meagmohit/vgalib/displayImage/Schematic.BMP

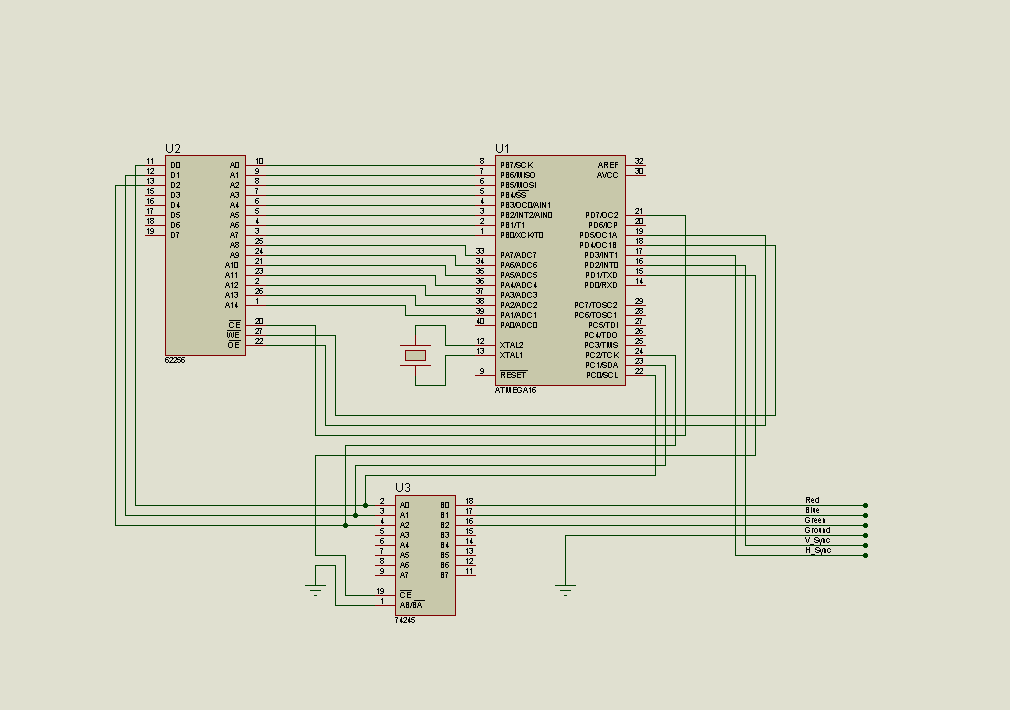
displayImage/Schematic.BMP
