meagmohit/vgalib/(list of files, drawings)

Other design files:
displayImage/Schematic.DSN
pingpong/Game Schematic.DSN
vgalib/Schematic.DSN
