meagmohit/vgalib/displayImage/symbol_tbl.h

prog_char symbol[]={


0b00000111,0b00000111,0b00000111,0b00000111,0b00000111,0b00000111,0b00000111,0b00000111,0b00000111,0b00000111,0b00000111,0b00000111,0b00000111,0b00000111,0b00000111,0b00000111,0b00000111,0b00000111,0b00000111,0b00000111,0b00000111,0b00000111,0b00000111,0b00000111,0b00000111,0b00000111,0b00000111,0b00000111,0b00000111,0b00000111,0b00000111,0b00000111,0b00000111,0b00000111,0b00000111,0b00000111,0b00000111,0b00000111,0b00000111,0b00000111,0b00000111,0b00000111,0b00000111,0b00000111,0b00000111,0b00000111,0b00000111,0b00000111,0b00000111,0b00000111,0b00000111,0b00000111,0b00000111,0b00000111,0b00000111,0b00000111,0b00000111,0b00000111,0b00000111,0b00000111,0b00000111,0b00000111,0b00000111,0b00000111,0b00000111,0b00000111,0b00000111,0b00000111,0b00000111,0b00000111,0b00000111,0b00000111,0b00000111,0b00000111,0b00000111,0b00000111,0b00000111,0b00000111,0b00000111,0b00000111,0b00000111,0b00000111,0b00000111,0b00000111,0b00000111,0b00000111,0b00000111,0b00000111,0b00000111,0b00000111,0b00000111,0b00000111,0b00000111,0b00000111,0b00000111,0b00000111,0b00000111,0b00000111,0b00000111,0b00000111,0b00000111,0b00000111,0b00000111,0b00000111,0b00000111,0b00000111,0b00000111,0b00000111,0b00000111,0b00000111,0b00000111,0b00000111,0b00000111,0b00000111,0b00000111,0b00000111,0b00000111,0b00000111,0b00000111,0b00000111,0b00000111,0b00000111,0b00000111,0b00000111,0b00000111,0b00000111,0b00000111,0b00000111,0b00000111,0b00000111,0b00000111,0b00000111,0b00000111,0b00000111,0b00000111,0b00000111,0b00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
b00000111,0b00000111,0b00000111,0b00000111,0b00000111,0b00000111,0b00000111,0b00000111,0b00000111,0b00000111,0b00000111,0b00000111,0b00000111,0b00000111,0b00000111,0b00000111,0b00000111,0b00000111,0b00000111,0b00000111,0b00000111,0b00000111,0b00000111,0b00000111,0b00000111,0b00000111,0b00000111,0b00000111,0b00000111,0b00000111,0b00000111,0b00000111,0b00000111,0b00000111,0b00000111,0b00000111,0b00000111,0b00000111,0b00000111,0b00000111,0b00000111,0b00000111,0b00000111,0b00000111,0b00000111,0b00000111,0b00000111,0b00000111,0b00000111,0b00000111,0b00000111,0b00000111,0b00000111,0b00000111,0b00000111,0b00000111,0b00000111,0b00000111,0b00000111,0b00000111,0b00000111,0b00000111,0b00000111,0b00000111,0b00000111,0b00000111,0b00000111,0b00000111,0b00000111,0b00000111,0b00000111,0b00000111,0b00000111,0b00000111,0b00000111,0b00000111,0b00000111,0b00000111,0b00000111,0b00000111

};
