meagmohit/vgalib/pingpong/symbol_tbl.h

prog_char symbol2[]={


0b00000000,0b00000000,0b00000000,0b00000000,0b00000000,0b00000000,0b00000000,0b00000000,0b00000000,0b00000000,0b00000000,0b00000000,0b00000000,0b00000000,0b00000000,0b00000000,0b00000000,0b00000000,0b00000000,0b00000000,0b00000000,0b00000000,0b00000000,0b00000000,0b00000000,0b00000000,0b00000000,0b00000000,0b00000000,0b00000000,0b00000000,0b00000000,0b00000000,0b00000000,0b00000000,0b00000000,0b00000000,0b00000000,0b00000000,0b00000000,0b00000000,0b00000000,0b00000000,0b00000000,0b00000000,0b00000000,0b00000000,0b00000000,0b00000000,0b00000000,0b00000000,0b00000000,0b00000000,0b00000000,0b00000000,0b00000000,0b00000000,0b00000000,0b00000000,0b00000000,0b00000000,0b00000000,0b00000000,0b00000000,0b00000000,0b00000000,0b00000000,0b00000000,0b00000000,0b00000000,0b00000000,0b00000000,0b00000000,0b00000000,0b00000000,0b00000000,0b00000000,0b00000000,0b00000000,0b00000000,0b00000000,0b00000000,0b00000000,0b00000000,0b00000000,0b00000000,0b00000000,0b00000000,0b00000000,0b00000000,0b00000000,0b00000000,0b00000000,0b00000000,0b00000000,0b00000000,0b00000000,0b00000000,0b00000000,0b00000000,0b00000000,0b00000000,0b00000000,0b00000000,0b00000000,0b00000000,0b00000000,0b00000000,0b00000000,0b00000000,0b00000000,0b00000000,0b00000000,0b00000000,0b00000000,0b00000000,0b00000000,0b00000000,0b00000000,0b00000000,0b00000000,0b00000000,0b00000000,0b00000000,0b00000000,0b00000000,0b00000000,0b00000000,0b00000000,0b00000000,0b00000000,0b00000000,0b00000000,0b00000000,0b00000000,0b00000000,0b00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
00000000,0b00000000,0b00000000,0b00000001,0b00000001,0b00000000,0b00000000,0b00000000,0b00000000,0b00000001,0b00000001,0b00000000,0b00000000,0b00000000,0b00000000,0b00000001,0b00000001,0b00000000,0b00000000,0b00000000,0b00000000,0b00000001,0b00000001,0b00000000,0b00000000,0b00000000,0b00000000,0b00000001,0b00000001,0b00000000,0b00000000,0b00000000,0b00000000,0b00000001,0b00000001,0b00000001,0b00000001,0b00000001,0b00000001,0b00000001,0b00000000,0b00000000,0b00000000,0b00000000,0b00000000,0b00000001,0b00000000,0b00000000,0b00000000,0b00000000,0b00000000,0b00000001,0b00000000,0b00000000,0b00000000,0b00000000,0b00000000,0b00000001,0b00000000,0b00000000,0b00000000,0b00000000,0b00000000,0b00000001,0b00000000,0b00000000,0b00000000,0b00000000,0b00000000,0b00000001,0b00000000,0b00000000,0b00000000,0b00000000,0b00000000,0b00000001,0b00000000,0b00000000,0b00000000,0b00000000,0b00000000,0b00000001
};
